Gmanmodz/U-AMP/UAMP PINOUT.png

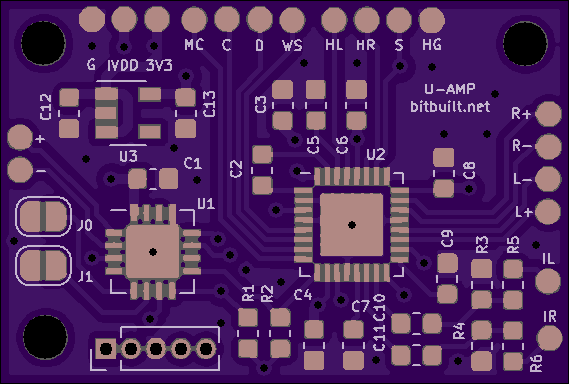
UAMP PINOUT.png
