Gmanmodz/U-AMP/U-Amp BOM.xlsx

Reference | Description | Quantity | Part number | Link
U1 | PIC16LF15324-I/JQ | 1 | PIC16LF15324-I/JQ | https://www.digikey.com/product-detail/en/microchip-technology/PIC16LF15324-I-JQ/PIC16LF15324-I-JQ-ND/6691288
U2 | IC AUDIO SUBSYSTEM 2.5W D 32WQFN | 1 | LM49450SQ/NOPB | https://www.digikey.com/product-detail/en/texas-instruments/LM49450SQ-NOPB/LM49450SQ-NOPBCT-ND/1994012
U3 | IC REG LINEAR 2.5V 250MA SOT23-5 | 1 | LP5907MFX-2.5/NOPB | https://www.digikey.com/product-detail/en/texas-instruments/LP5907MFX-2.5-NOPB/296-40356-1-ND/5178233
R1,2,5,6 | 10k | 4 | RC0603FR-0710KL | https://www.digikey.com/product-detail/en/yageo/RC0603FR-0710KL/311-10.0KHRCT-ND/729827
R3,4 | 4.7k | 2 | RC0603FR-074K7L | https://www.digikey.com/product-detail/en/yageo/RC0603FR-074K7L/311-4.70KHRCT-ND/730159
C1 | .1uf | 1 | CL10B104KB8NNNC | https://www.digikey.com/product-detail/en/samsung-electro-mechanics/CL10B104KB8NNNC/1276-1000-1-ND/3889086
C2,3,4,5,6,8,9 | 2.2uf | 7 | GRM188R6YA225MA12D | https://www.digikey.com/product-detail/en/murata-electronics-north-america/GRM188R6YA225MA12D/490-10486-1-ND/5026404
C7 | 10uf | 1 | GRM188R61A106ME69D | https://www.digikey.com/product-detail/en/murata-electronics-north-america/GRM188R61A106ME69D/490-10475-1-ND/5026393
C10,11,1213 | 1uf | 4 | CL10A105KB8NNNC | https://www.digikey.com/product-detail/en/samsung-electro-mechanics/CL10A105KB8NNNC/1276-1860-1-ND/3889946
