Gmanmodz/U-AMP/UAMP PCB FILES/UniAmp.kicad_pcb

## KiCad design UAMP PCB FILES/UniAmp.kicad_pcb (2020-01-02)

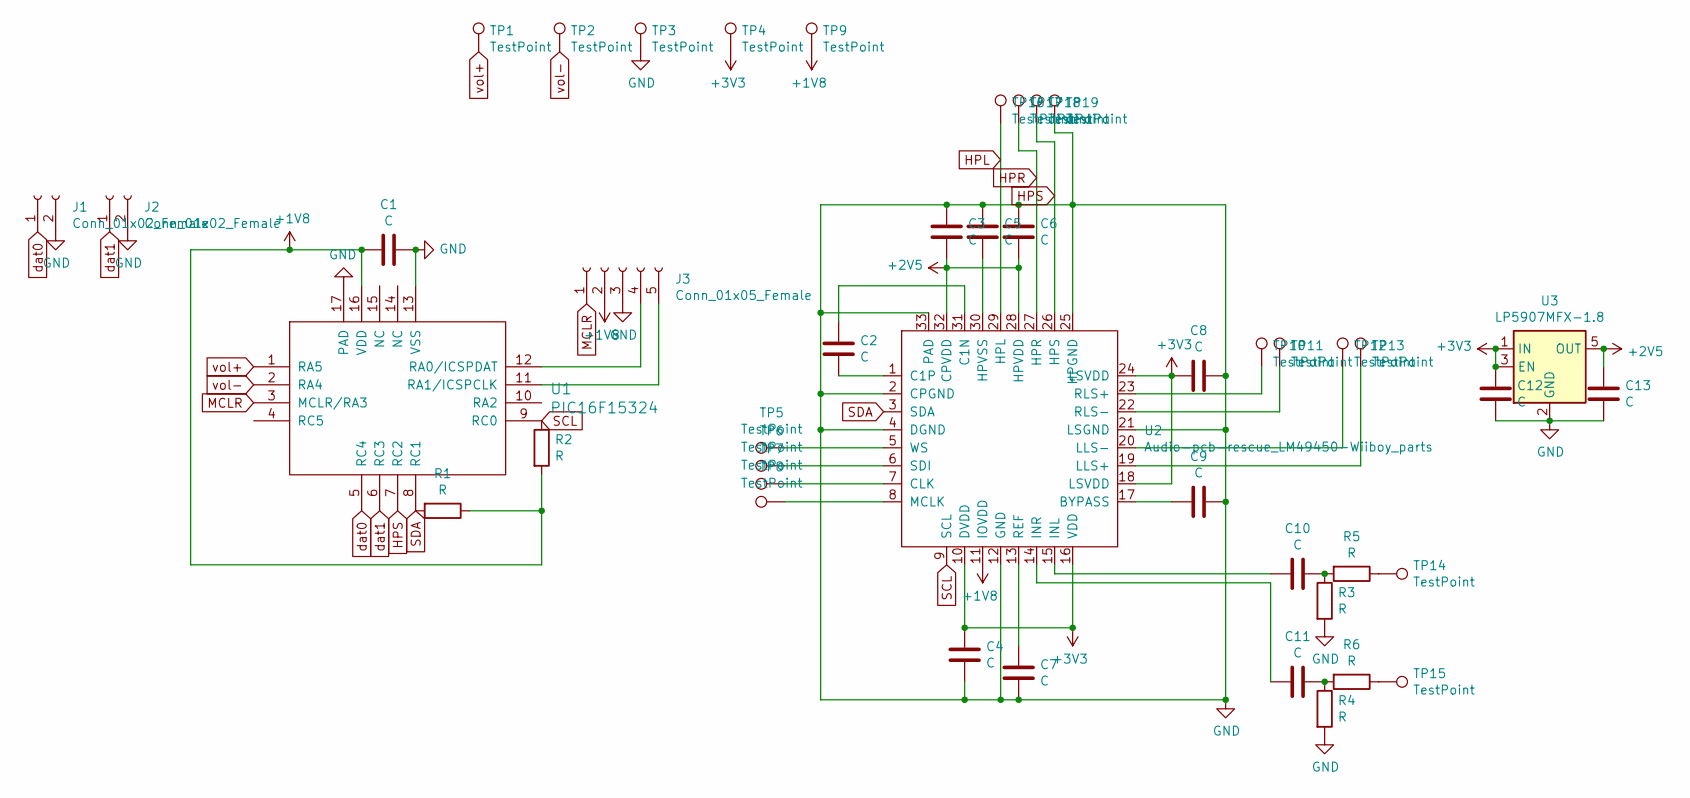
[picture p2: schematic UniAmp.sch]

Parts:
C1, C2, C3, C4, C5, C6, C7, C8, C9, C10, C11, C12, C13: C; C_0603_1608Metric
J1, J2: Conn_01x02_Female; SolderJumper-2_P1.3mm_Open_RoundedPad1.0x1.5mm
J3: Conn_01x05_Female; PinHeader_1x05_P1.27mm_Vertical
R1, R2, R3, R4, R5, R6: R; R_0603_1608Metric
TP1, TP2, TP3, TP4, TP5, TP6, TP7, TP8, TP9, TP10, TP11, TP12, TP13, TP14, TP15, TP16, TP17, TP18, TP19: TestPoint; 1.25mm pad
U1: PIC16F15324; QFN-16-1EP_4x4mm_P0.65mm_EP2.7x2.7mm
U2: Audio-pcb-rescue_LM49450-Wiiboy_parts; QFN-32-1EP_5x5mm_P0.5mm_EP3.1x3.1mm
U3: LP5907MFX-1.8; SOT-23-5

Connections:
+1V8: C1.2, J3.2, R1.1, R2.2, TP9.1, U1.16 (VDD), U2.11 (IOVDD)
+2V5: C3.2, C6.2, C13.1, U2.28 (HPVDD), U2.32 (CPVDD), U3.5 (OUT)
+3V3: C4.1, C8.2, C12.1, TP4.1, U2.10 (DVDD), U2.16 (VDD), U2.18 (LSVDD), U2.24 (LSVDD), U3.1 (IN), U3.3 (EN)
GND: C1.1, C3.1, C4.2, C5.1, C6.1, C7.2, C8.1, C9.1, C12.2, C13.2, J1.2, J2.2, J3.3, R3.2, R4.2, TP3.1, TP19.1, U1.13 (VSS), U1.17 (PAD), U2.2 (CPGND), U2.4 (DGND), U2.12 (GND), U2.21 (LSGND), U2.25 (HPGND), U2.33 (PAD), U3.2 (GND)
HPL: TP16.1, U2.29 (HPL)
HPR: TP17.1, U2.27 (HPR)
HPS: TP18.1, U1.7 (RC2), U2.26 (HPS)
MCLR: J3.1, U1.3 (MCLR/RA3)
unnamed: C2.1, U2.31 (C1N)
unnamed: C2.2, U2.1 (C1P)
unnamed: C5.2, U2.30 (HPVSS)
unnamed: C7.1, U2.13 (REF)
unnamed: C9.2, U2.17 (BYPASS)
unnamed: C10.1, R3.1, R5.2
unnamed: C10.2, U2.15 (INL)
unnamed: C11.1, R4.1, R6.2
unnamed: C11.2, U2.14 (INR)
unnamed: J3.4, U1.12 (RA0/ICSPDAT)
unnamed: J3.5, U1.11 (RA1/ICSPCLK)
unnamed: R5.1, TP14.1
unnamed: R6.1, TP15.1
unnamed: TP5.1, U2.5 (WS)
unnamed: TP6.1, U2.6 (SDI)
unnamed: TP7.1, U2.7 (CLK)
unnamed: TP8.1, U2.8 (MCLK)
unnamed: TP10.1, U2.23 (RLS+)
unnamed: TP11.1, U2.22 (RLS-)
unnamed: TP12.1, U2.20 (LLS-)
unnamed: TP13.1, U2.19 (LLS+)
SCL: R2.1, U1.9 (RC0), U2.9 (SCL)
SDA: R1.2, U1.8 (RC1), U2.3 (SDA)
dat0: J1.1, U1.5 (RC4)
dat1: J2.1, U1.6 (RC3)
vol+: TP1.1, U1.1 (RA5)
vol-: TP2.1, U1.2 (RA4)

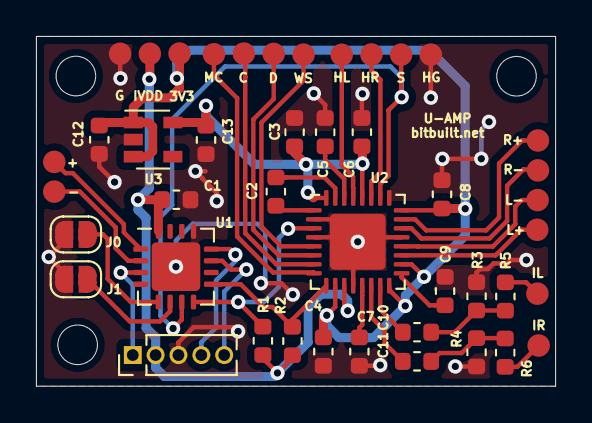
[picture p3: board UniAmp.kicad_pcb from above]

Board: 2 copper layers, 28.8 x 19.4 mm, 44 parts (0 on the bottom side), 35 nets.
