Gmanmodz/U-AMP/(threads)

Thread 2 (2020-04-09):

Having trouble with files

Langferd, 2020-04-09:
Thanks so much for putting this up for opensource. I was able to download the files that are provided but I am having trouble opening them at this time.
When I go to open UniAmp.sch in Eagle this window appears:

Error:
line 1, column 1: Start tag expected.

It might be because of a software update or some other problem but I am not so sure.
I also tried opening the file in EasyEDA but I didn't have any luck with that either.
I hope to get a reply soon, thanks.

Aurelio92, 2020-04-09:
The project is for KiCAD, not Eagle
