Gmanmodz/U-AMP/(commit log)

2019-11-10 mute
    added logic for handling mute when both buttons are pressed.
2020-01-01 Changed to LF pic and turned off brownout reset
    [PICCONFIG_UAMP.h]
2020-01-02 Added pcb files
    [UniAmp-B_Cu.gbr, UniAmp-B_Mask.gbr, UniAmp-B_Paste.gbr, UniAmp-B_SilkS.gbr, UniAmp-Edge_Cuts.gbr, UniAmp-F_Cu.gbr, UniAmp-F_Mask.gbr, UniAmp-F_Paste.gbr]
2020-01-02 Added BOM
    [U-Amp BOM.xlsx]
2020-04-18 Changed the PS2 I2S config
    Found a mistake in the config that caused distortion on audio peaks.
    [LM49450.c]
